georgerennie/HWHacker/board/kicad_project/hw_hacker.kicad_pcb

## KiCad design board/kicad_project/hw_hacker.kicad_pcb (2022-02-13)

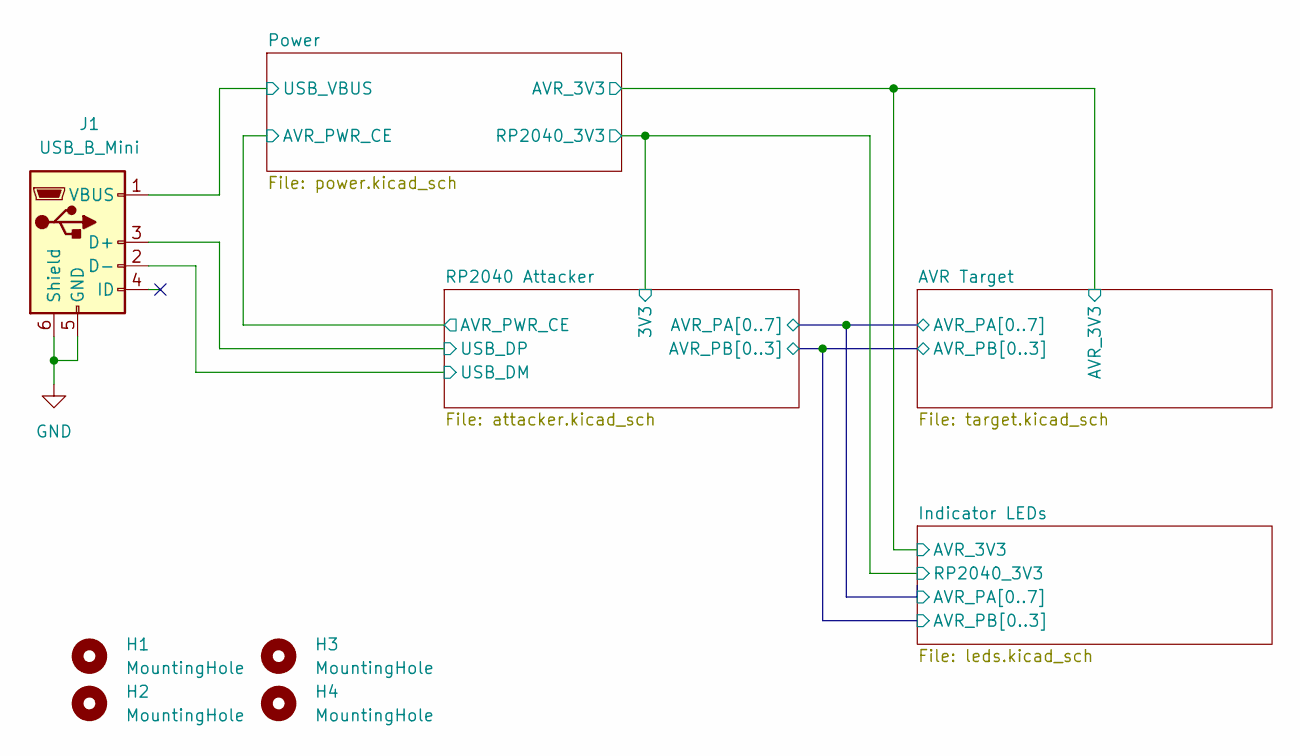
[picture p1: schematic hw_hacker.kicad_sch, SUCSS Hardware Hacker]

Parts:
H1, H2, H3, H4: MountingHole; MountingHole_3.2mm_M3; JLCPCB BOM 0
J1: USB_B_Mini; USB_Mini-B_Lumberg_2486_01_Horizontal; LCSC Part C91144

Connections:
/Power/USB_VBUS: J1.1 (VBUS); also elsewhere on the board
/RP2040 Attacker/USB_DM: J1.2 (D-); also elsewhere on the board
/RP2040 Attacker/USB_DP: J1.3 (D+); also elsewhere on the board
GND: J1.5 (GND), J1.6 (Shield); also elsewhere on the board

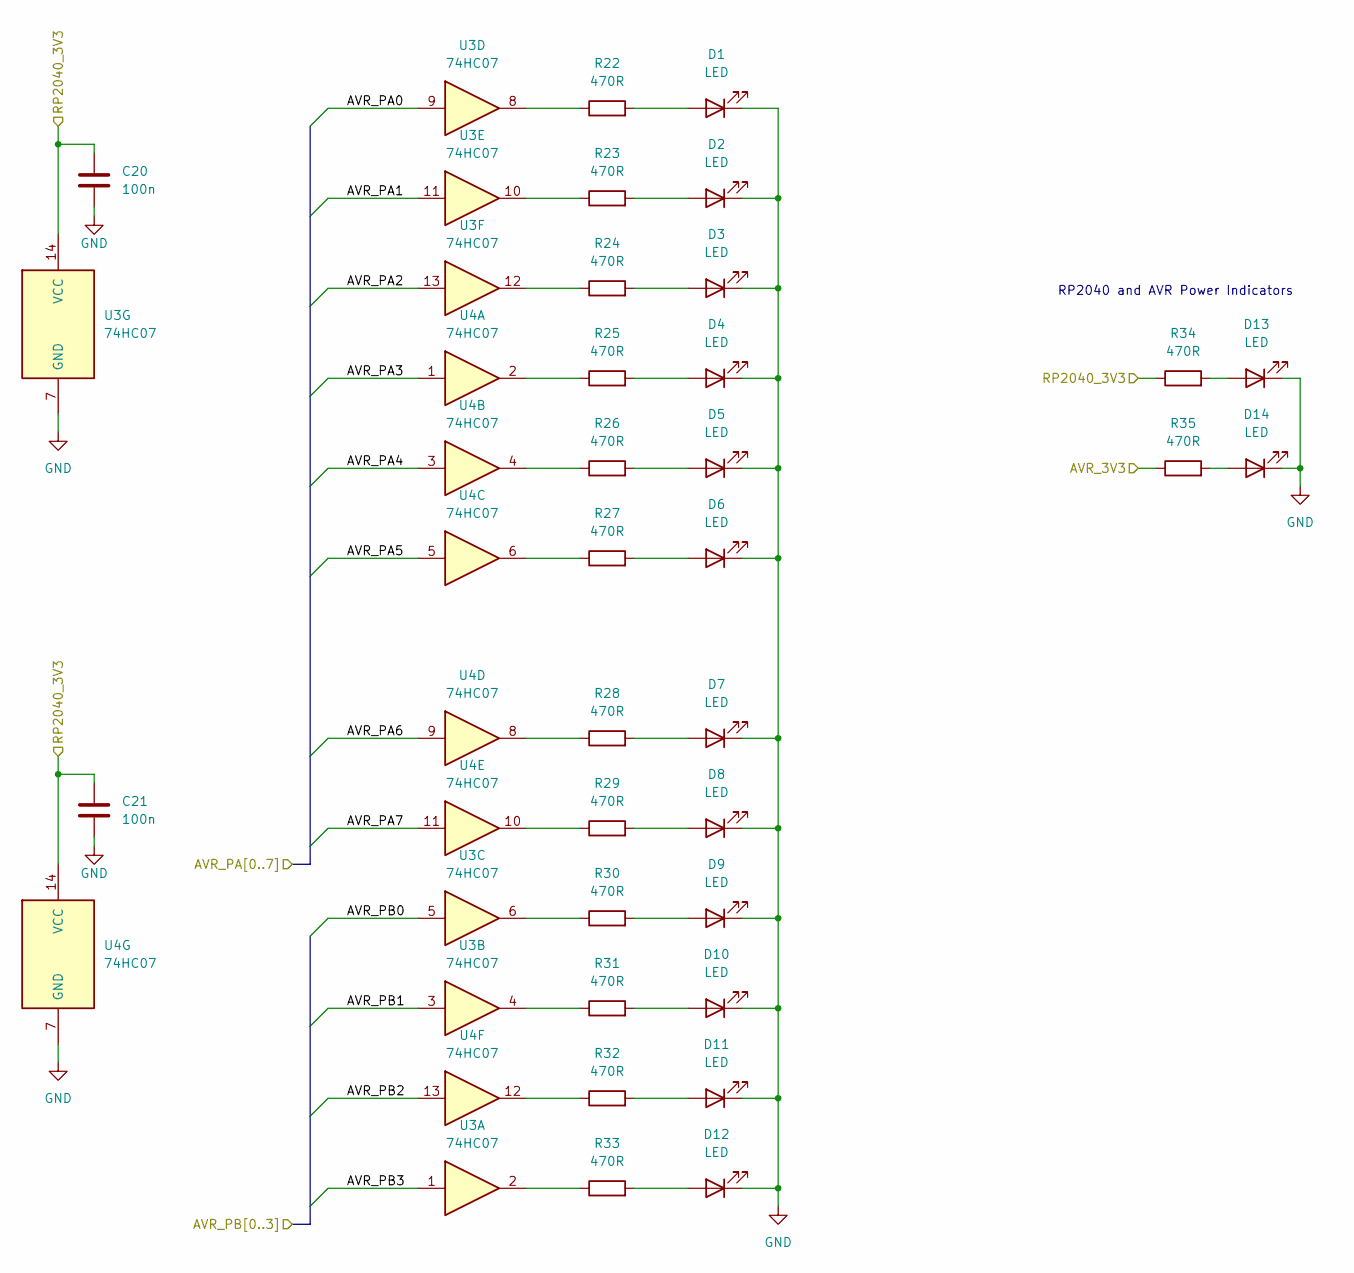
[picture p2: schematic leds.kicad_sch, SUCSS Hardware Hacker]

Parts:
C20, C21: 100n; C_0805_2012Metric; LCSC Part C49678
D1, D2, D3, D4, D5, D6, D7, D8, D9, D10, D11, D12, D13, D14: LED; LED_0603_1608Metric; LCSC Part C72041
R22, R23, R24, R25, R26, R27, R28, R29, R30, R31, R32, R33, R34, R35: 470R; R_0805_2012Metric; LCSC Part C17710
U3, U4: 74HC07; SOIC-14_3.9x8.7mm_P1.27mm; LCSC Part C512771

Connections:
/AVR Target/AVR_3V3: R35.1; also elsewhere on the board
/AVR Target/AVR_PA0: U3.9; also elsewhere on the board
/AVR Target/AVR_PA1: U3.11; also elsewhere on the board
/AVR Target/AVR_PA2: U3.13; also elsewhere on the board
/AVR Target/AVR_PA3: U4.1; also elsewhere on the board
/AVR Target/AVR_PA4: U4.3; also elsewhere on the board
/AVR Target/AVR_PA5: U4.5; also elsewhere on the board
/AVR Target/AVR_PA6: U4.9; also elsewhere on the board
/AVR Target/AVR_PA7: U4.11; also elsewhere on the board
/AVR Target/AVR_PB0: U3.5; also elsewhere on the board
/AVR Target/AVR_PB1: U3.3; also elsewhere on the board
/AVR Target/AVR_PB2: U4.13; also elsewhere on the board
/AVR Target/AVR_PB3: U3.1; also elsewhere on the board
/Indicator LEDs/RP2040_3V3: C20.1, C21.1, R34.1, U3.14 (VCC), U4.14 (VCC); also elsewhere on the board
GND: C20.2, C21.2, D1.1 (K), D2.1 (K), D3.1 (K), D4.1 (K), D5.1 (K), D6.1 (K), D7.1 (K), D8.1 (K), D9.1 (K), D10.1 (K), D11.1 (K), D12.1 (K), D13.1 (K), D14.1 (K), U3.7 (GND), U4.7 (GND); also elsewhere on the board
unnamed: D1.2 (A), R22.2
unnamed: D2.2 (A), R23.2
unnamed: D3.2 (A), R24.2
unnamed: D4.2 (A), R25.2
unnamed: D5.2 (A), R26.2
unnamed: D6.2 (A), R27.2
unnamed: D7.2 (A), R28.2
unnamed: D8.2 (A), R29.2
unnamed: D9.2 (A), R30.2
unnamed: D10.2 (A), R31.2
unnamed: D11.2 (A), R32.2
unnamed: D12.2 (A), R33.2
unnamed: D13.2 (A), R34.2
unnamed: D14.2 (A), R35.2
unnamed: R22.1, U3.8
unnamed: R23.1, U3.10
unnamed: R24.1, U3.12
unnamed: R25.1, U4.2
unnamed: R26.1, U4.4
unnamed: R27.1, U4.6
unnamed: R28.1, U4.8
unnamed: R29.1, U4.10
unnamed: R30.1, U3.6
unnamed: R31.1, U3.4
unnamed: R32.1, U4.12
unnamed: R33.1, U3.2

Notes on the sheet:
RP2040 and AVR Power Indicators

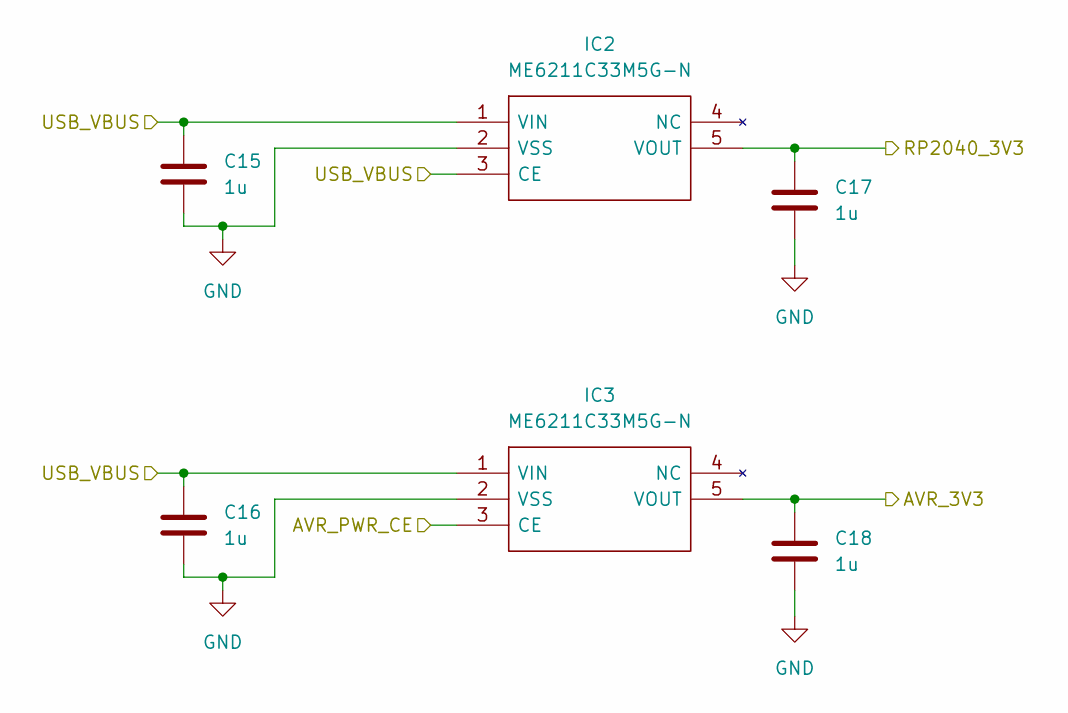
[picture p3: schematic power.kicad_sch, SUCSS Hardware Hacker]

Parts:
C15, C16, C17, C18: 1u; C_0805_2012Metric; LCSC Part C28323
IC2, IC3: ME6211C33M5G-N; SOT-23-5; Manufacturer_Part_Number ME6211C33M5G-N; LCSC Part C82942

Connections:
/AVR Target/AVR_3V3: C18.1, IC3.5 (VOUT); also elsewhere on the board
/Indicator LEDs/RP2040_3V3: C17.1, IC2.5 (VOUT); also elsewhere on the board
/Power/AVR_PWR_CE: IC3.3 (CE); also elsewhere on the board
/Power/USB_VBUS: C15.1, C16.1, IC2.1 (VIN), IC2.3 (CE), IC3.1 (VIN); also elsewhere on the board
GND: C15.2, C16.2, C17.2, C18.2, IC2.2 (VSS), IC3.2 (VSS); also elsewhere on the board

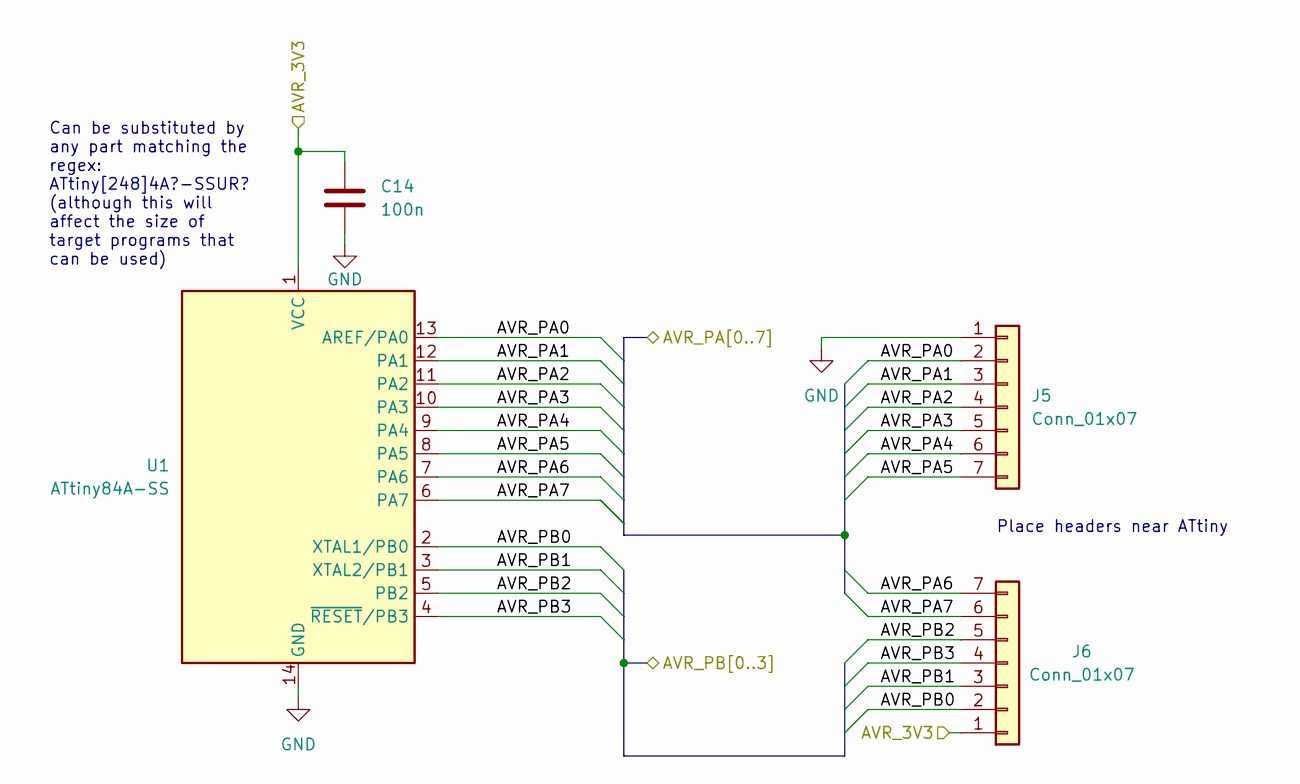
[picture p4: schematic target.kicad_sch, SUCSS Hardware Hacker]

Parts:
C14: 100n; C_0805_2012Metric; LCSC Part C49678
J5, J6: Conn_01x07; PinHeader_1x07_P2.54mm_Vertical; JLCPCB BOM 0
U1: ATtiny84A-SS; SOIC-14_3.9x8.7mm_P1.27mm; LCSC Part C14909

Connections:
/AVR Target/AVR_3V3: C14.1, J6.1, U1.1 (VCC); also elsewhere on the board
/AVR Target/AVR_PA0: J5.2, U1.13 (AREF/PA0); also elsewhere on the board
/AVR Target/AVR_PA1: J5.3, U1.12 (PA1); also elsewhere on the board
/AVR Target/AVR_PA2: J5.4, U1.11 (PA2); also elsewhere on the board
/AVR Target/AVR_PA3: J5.5, U1.10 (PA3); also elsewhere on the board
/AVR Target/AVR_PA4: J5.6, U1.9 (PA4); also elsewhere on the board
/AVR Target/AVR_PA5: J5.7, U1.8 (PA5); also elsewhere on the board
/AVR Target/AVR_PA6: J6.7, U1.7 (PA6); also elsewhere on the board
/AVR Target/AVR_PA7: J6.6, U1.6 (PA7); also elsewhere on the board
/AVR Target/AVR_PB0: J6.2, U1.2 (XTAL1/PB0); also elsewhere on the board
/AVR Target/AVR_PB1: J6.3, U1.3 (XTAL2/PB1); also elsewhere on the board
/AVR Target/AVR_PB2: J6.5, U1.5 (PB2); also elsewhere on the board
/AVR Target/AVR_PB3: J6.4, U1.4 (~RESET/PB3); also elsewhere on the board
GND: C14.2, J5.1, U1.14 (GND); also elsewhere on the board

Notes on the sheet:
Can be substituted by any part matching the regex: ATtiny[248]4A?-SSUR? (although this will affect the size of target programs that can be used)
Place headers near ATtiny

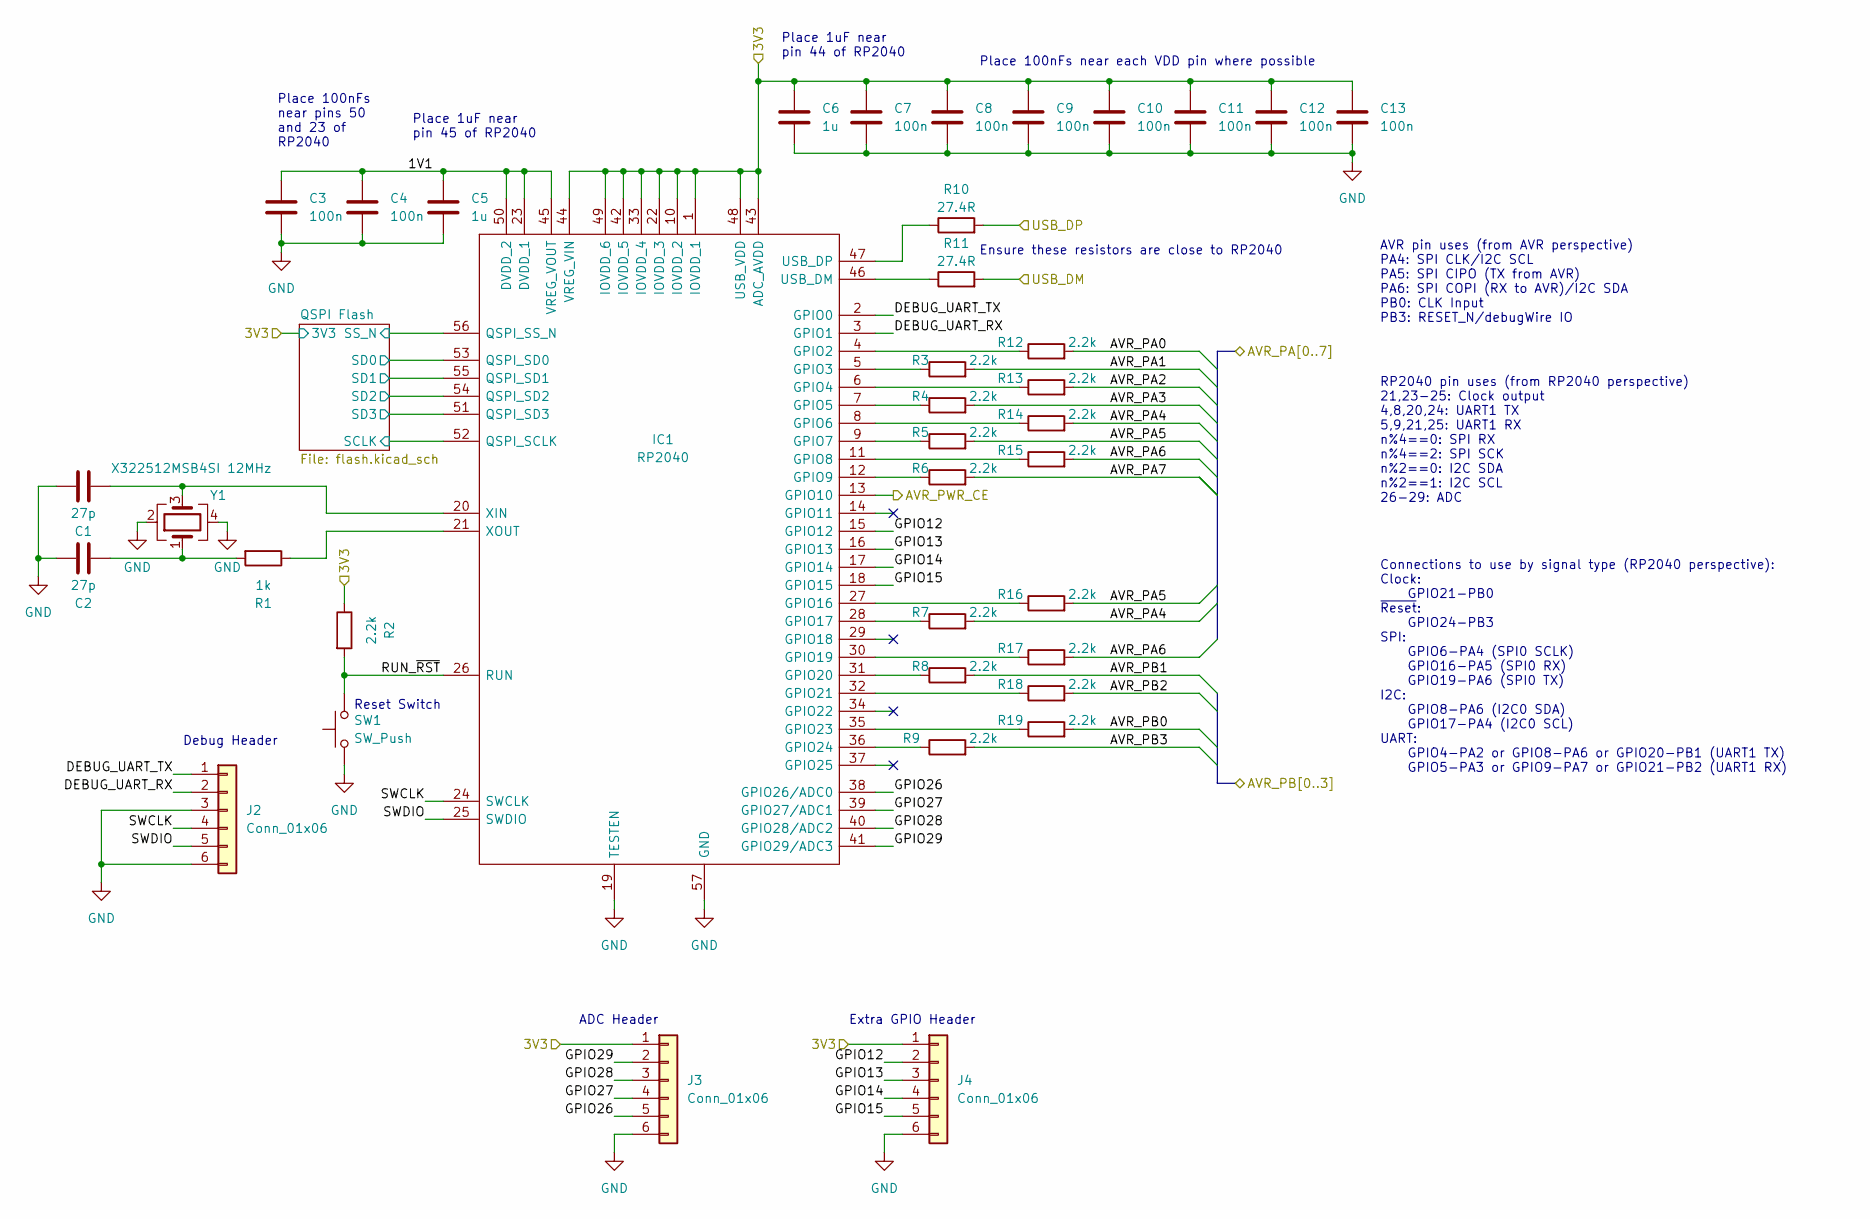
[picture p5: schematic attacker.kicad_sch, SUCSS Hardware Hacker]

Parts:
C1, C2: 27p; C_0402_1005Metric; LCSC Part C1557
C3, C4, C7, C8, C9, C10, C11, C12, C13: 100n; C_0402_1005Metric; LCSC Part C1525
C5, C6: 1u; C_0805_2012Metric; LCSC Part C28323
IC1: RP2040; RP2040-QFN-56; Manufacturer_Part_Number RP2040; LCSC Part C2040
J2, J3, J4: Conn_01x06; PinHeader_1x06_P2.54mm_Vertical; JLCPCB BOM 0
R1: 1k; R_0402_1005Metric; LCSC Part C11702
R2, R3, R4, R5, R6, R7, R8, R9, R12, R13, R14, R15, R16, R17, R18, R19: 2.2k; R_0603_1608Metric; LCSC Part C4190
R10, R11: 27.4R; R_0402_1005Metric; LCSC Part C172043
SW1: SW_Push; SW_SPST_SKQG_WithStem; LCSC Part C318884
Y1: X322512MSB4SI 12MHz; Crystal_SMD_3225-4Pin_3.2x2.5mm; LCSC Part C9002

Connections:
/AVR Target/AVR_PA0: R12.2; also elsewhere on the board
/AVR Target/AVR_PA1: R3.2; also elsewhere on the board
/AVR Target/AVR_PA2: R13.2; also elsewhere on the board
/AVR Target/AVR_PA3: R4.2; also elsewhere on the board
/AVR Target/AVR_PA4: R7.2, R14.2; also elsewhere on the board
/AVR Target/AVR_PA5: R5.2, R16.2; also elsewhere on the board
/AVR Target/AVR_PA6: R15.2, R17.2; also elsewhere on the board
/AVR Target/AVR_PA7: R6.2; also elsewhere on the board
/AVR Target/AVR_PB0: R19.2; also elsewhere on the board
/AVR Target/AVR_PB1: R8.2; also elsewhere on the board
/AVR Target/AVR_PB2: R18.2; also elsewhere on the board
/AVR Target/AVR_PB3: R9.2; also elsewhere on the board
/Indicator LEDs/RP2040_3V3: C6.1, C7.1, C8.1, C9.1, C10.1, C11.1, C12.1, C13.1, IC1.1 (IOVDD_1), IC1.10 (IOVDD_2), IC1.22 (IOVDD_3), IC1.33 (IOVDD_4), IC1.42 (IOVDD_5), IC1.43 (ADC_AVDD), IC1.44 (VREG_VIN), IC1.48 (USB_VDD), IC1.49 (IOVDD_6), J3.1, J4.1, R2.1; also elsewhere on the board
/Power/AVR_PWR_CE: IC1.13 (GPIO10); also elsewhere on the board
/RP2040 Attacker/1V1: C3.1, C4.1, C5.1, IC1.23 (DVDD_1), IC1.45 (VREG_VOUT), IC1.50 (DVDD_2)
/RP2040 Attacker/DEBUG_UART_RX: IC1.3 (GPIO1), J2.2
/RP2040 Attacker/DEBUG_UART_TX: IC1.2 (GPIO0), J2.1
/RP2040 Attacker/GPIO12: IC1.15 (GPIO12), J4.2
/RP2040 Attacker/GPIO13: IC1.16 (GPIO13), J4.3
/RP2040 Attacker/GPIO14: IC1.17 (GPIO14), J4.4
/RP2040 Attacker/GPIO15: IC1.18 (GPIO15), J4.5
/RP2040 Attacker/GPIO26: IC1.38 (GPIO26/ADC0), J3.5
/RP2040 Attacker/GPIO27: IC1.39 (GPIO27/ADC1), J3.4
/RP2040 Attacker/GPIO28: IC1.40 (GPIO28/ADC2), J3.3
/RP2040 Attacker/GPIO29: IC1.41 (GPIO29/ADC3), J3.2
/RP2040 Attacker/QSPI Flash/SCLK: IC1.52 (QSPI_SCLK); also elsewhere on the board
/RP2040 Attacker/QSPI Flash/SD0: IC1.53 (QSPI_SD0); also elsewhere on the board
/RP2040 Attacker/QSPI Flash/SD1: IC1.55 (QSPI_SD1); also elsewhere on the board
/RP2040 Attacker/QSPI Flash/SD2: IC1.54 (QSPI_SD2); also elsewhere on the board
/RP2040 Attacker/QSPI Flash/SD3: IC1.51 (QSPI_SD3); also elsewhere on the board
/RP2040 Attacker/QSPI Flash/SS_N: IC1.56 (QSPI_SS_N); also elsewhere on the board
/RP2040 Attacker/RUN_~RST: IC1.26 (RUN), R2.2, SW1.2
/RP2040 Attacker/SWCLK: IC1.24 (SWCLK), J2.4
/RP2040 Attacker/SWDIO: IC1.25 (SWDIO), J2.5
/RP2040 Attacker/USB_DM: R11.2; also elsewhere on the board
/RP2040 Attacker/USB_DP: R10.2; also elsewhere on the board
GND: C1.2, C2.2, C3.2, C4.2, C5.2, C6.2, C7.2, C8.2, C9.2, C10.2, C11.2, C12.2, C13.2, IC1.19 (TESTEN), IC1.57 (GND), J2.3, J2.6, J3.6, J4.6, SW1.1, Y1.2, Y1.4; also elsewhere on the board
unnamed: C2.1, R1.2, Y1.1
unnamed: IC1.4 (GPIO2), R12.1
unnamed: IC1.5 (GPIO3), R3.1
unnamed: IC1.6 (GPIO4), R13.1
unnamed: IC1.7 (GPIO5), R4.1
unnamed: IC1.8 (GPIO6), R14.1
unnamed: IC1.9 (GPIO7), R5.1
unnamed: IC1.11 (GPIO8), R15.1
unnamed: IC1.12 (GPIO9), R6.1
unnamed: IC1.27 (GPIO16), R16.1
unnamed: IC1.28 (GPIO17), R7.1
unnamed: IC1.30 (GPIO19), R17.1
unnamed: IC1.31 (GPIO20), R8.1
unnamed: IC1.32 (GPIO21), R18.1
unnamed: IC1.35 (GPIO23), R19.1
unnamed: IC1.36 (GPIO24), R9.1
unnamed: IC1.46 (USB_DM), R11.1
unnamed: IC1.47 (USB_DP), R10.1
unnamed: C1.1, IC1.20 (XIN), Y1.3
unnamed: IC1.21 (XOUT), R1.1

Notes on the sheet:
Place 1uF near pin 44 of RP2040
Reset Switch
Place 1uF near pin 45 of RP2040
Place 100nFs near each VDD pin where possible
Ensure these resistors are close to RP2040
Connections to use by signal type (RP2040 perspective): Clock: GPIO21-PB0 ~{Reset}: GPIO24-PB3 SPI: GPIO6-PA4 (SPI0 SCLK) GPIO16-PA5 (SPI0 RX) GPIO19-PA6 (SPI0 TX) I2C: GPIO8-PA6 (I2C0 SDA) GPIO17-PA4 (I2C0 SCL) UART: GPIO4-PA2 or GPIO8-PA6 or GPIO20-PB1 (UART1 TX) GPIO5-PA3 or GPIO9-PA7 or GPIO21-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
Debug Header
ADC Header
AVR pin uses (from AVR perspective) PA4: SPI CLK/I2C SCL PA5: SPI CIPO (TX from AVR) PA6: SPI COPI (RX to AVR)/I2C SDA PB0: CLK Input PB3: RESET_N/debugWire IO
Extra GPIO Header
Place 100nFs near pins 50 and 23 of RP2040
RP2040 pin uses (from RP2040 perspective) 21,23-25: Clock output 4,8,20,24: UART1 TX 5,9,21,25: UART1 RX n%4==0: SPI RX n%4==2: SPI SCK n%2==0: I2C SDA n%2==1: I2C SCL 26-29: ADC

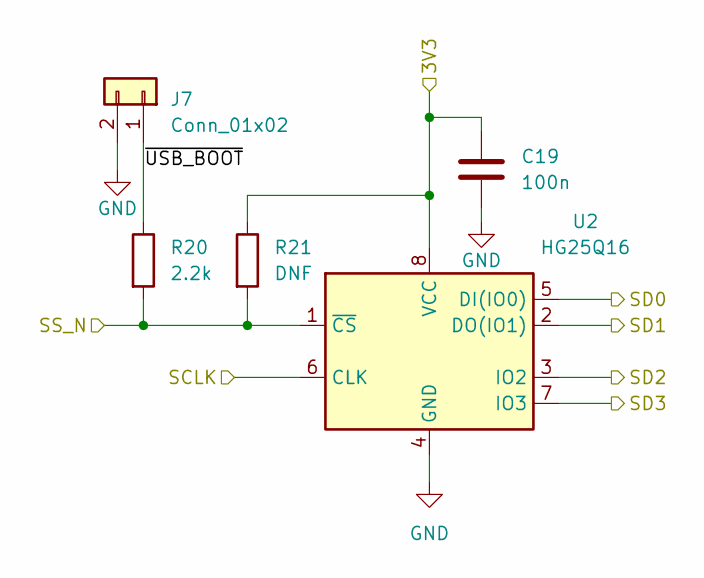
[picture p6: schematic flash.kicad_sch, SUCSS Hardware Hacker]

Parts:
C19: 100n; C_0805_2012Metric; LCSC Part C49678
J7: Conn_01x02; PinHeader_1x02_P2.54mm_Vertical; JLCPCB BOM 0
R20: 2.2k; R_0603_1608Metric; LCSC Part C4190
R21: DNF; R_0805_2012Metric; JLCPCB BOM 0
U2: HG25Q16; SOIC-8_5.23x5.23mm_P1.27mm; LCSC Part C2688463

Connections:
/Indicator LEDs/RP2040_3V3: C19.1, R21.1, U2.8 (VCC); also elsewhere on the board
/RP2040 Attacker/QSPI Flash/SCLK: U2.6 (CLK); also elsewhere on the board
/RP2040 Attacker/QSPI Flash/SD0: U2.5 (DI(IO0)); also elsewhere on the board
/RP2040 Attacker/QSPI Flash/SD1: U2.2 (DO(IO1)); also elsewhere on the board
/RP2040 Attacker/QSPI Flash/SD2: U2.3 (IO2); also elsewhere on the board
/RP2040 Attacker/QSPI Flash/SD3: U2.7 (IO3); also elsewhere on the board
/RP2040 Attacker/QSPI Flash/SS_N: R20.2, R21.2, U2.1 (~CS); also elsewhere on the board
/RP2040 Attacker/QSPI Flash/~USB_BOOT: J7.1, R20.1
GND: C19.2, J7.2, U2.4 (GND); also elsewhere on the board

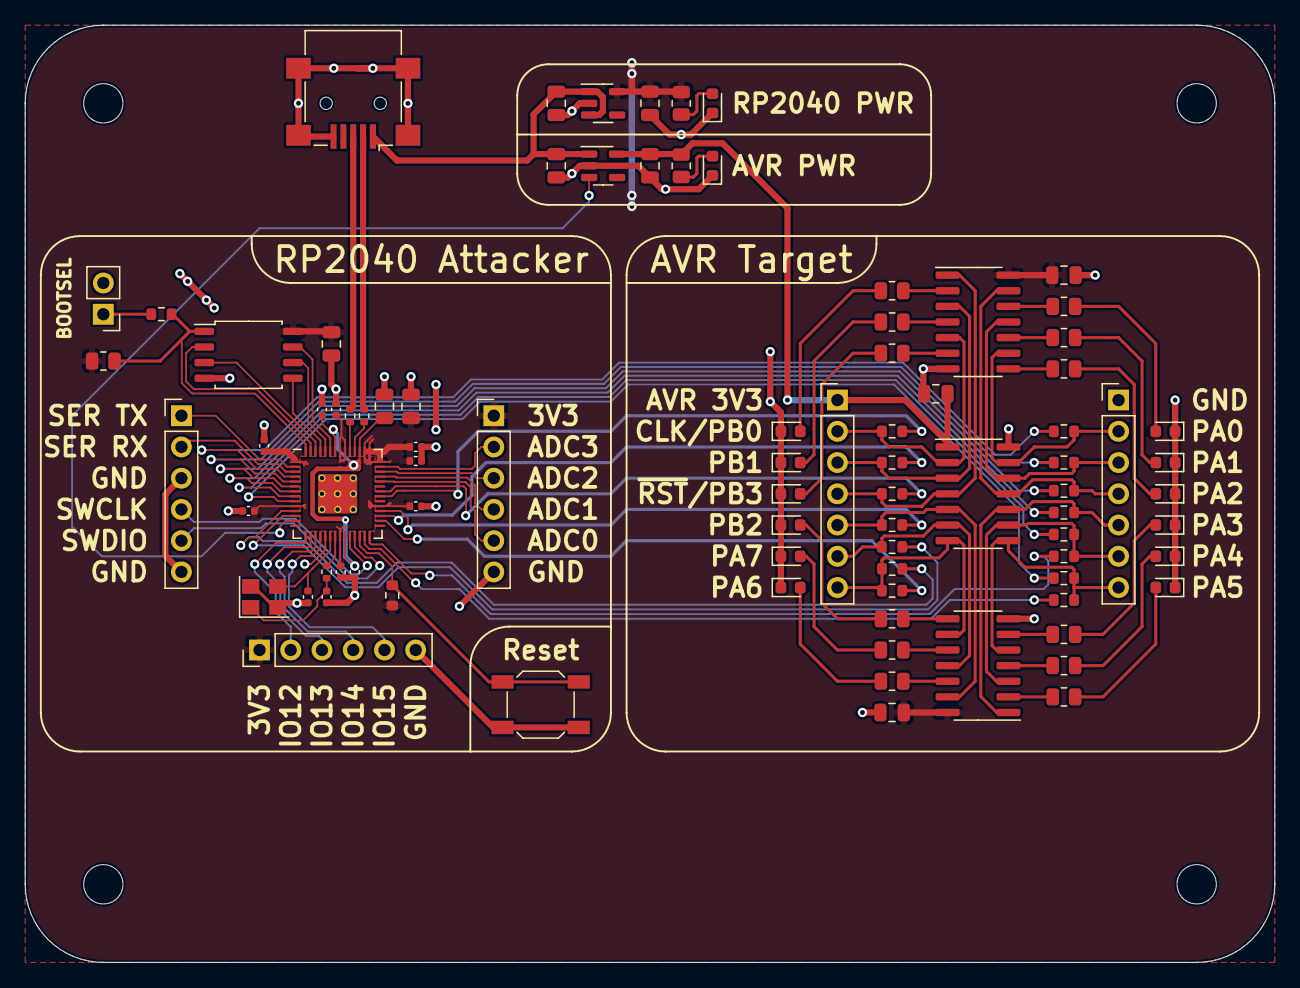
[picture p7: board hw_hacker.kicad_pcb from above]

Board: 2 copper layers, 101.6 x 76.2 mm, 90 parts (0 on the bottom side), 86 nets.
