georgerennie/HWHacker/(commit log)

2021-08-15 Initial schematic design
    [attacker.kicad_sch, flash.kicad_sch, hw_hacker.kicad_pcb, hw_hacker.kicad_sch, leds.kicad_sch, power.kicad_sch, target.kicad_sch]
2021-08-22 Initial board design
    [attacker.kicad_sch, flash.kicad_sch, hw_hacker.kicad_pcb, hw_hacker.kicad_sch, leds.kicad_sch, power.kicad_sch, target.kicad_sch]
2021-08-23 Fix failing DRC checks
    [hw_hacker.kicad_pcb]
2021-08-30 Added lcsc part numbers
    [attacker.kicad_sch, flash.kicad_sch, hw_hacker.kicad_sch, leds.kicad_sch, power.kicad_sch, target.kicad_sch]
2022-02-13 Update to kicad 6.99
    [attacker.kicad_sch, flash.kicad_sch, hw_hacker.kicad_pcb, hw_hacker.kicad_sch, leds.kicad_sch, power.kicad_sch, target.kicad_sch]
2022-02-13 Add LCSC part numbers to board file
    * Also replaced flash chip with cheaper/smaller HG25Q16 that should be
    pin compatible
    [flash.kicad_sch, hw_hacker.kicad_pcb, hw_hacker.kicad_sch]
